whmehaffey/Passive_Commutator_Intan_Interface/Passive Commutator Parts.xlsx

Company | Part | Part #
McMaster Carr | R4A , Plastic Bearing, Glass Ball. | 6455K52 (https://www.mcmaster.com/)
Omnetics | 12-pin Nano Polarized SMT | A79623-001
Moog, Inc. | Brush Block | AC259-10S:
 | Slip Ring | AC2690-10V (Vee Groove) or AC2690-10R (Raise Barrier) | (V- Groove is nice!)
Digikey | Conductive Silver Grease (https://www.digikey.com/product-detail/en/chemtronics/CW7100/CW7100-ND/307001) | CW7100-ND (https://www.digikey.com/product-detail/en/chemtronics/CW7100/CW7100-ND/307001)
