whmehaffey/Passive_Commutator_Intan_Interface/STL/Commutator_Top.stl

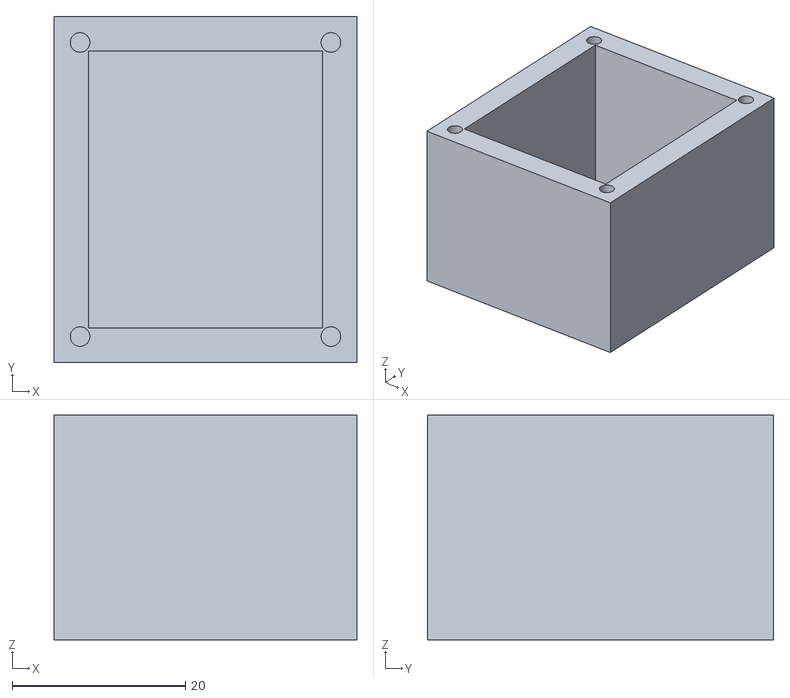
[picture p1: CAD file, 2018-09-08]
STL/Commutator_Top.stl
35.0 x 40.0 x 26.0
