whmehaffey/Passive_Commutator_Intan_Interface/STL/AC2690Sheath.stl

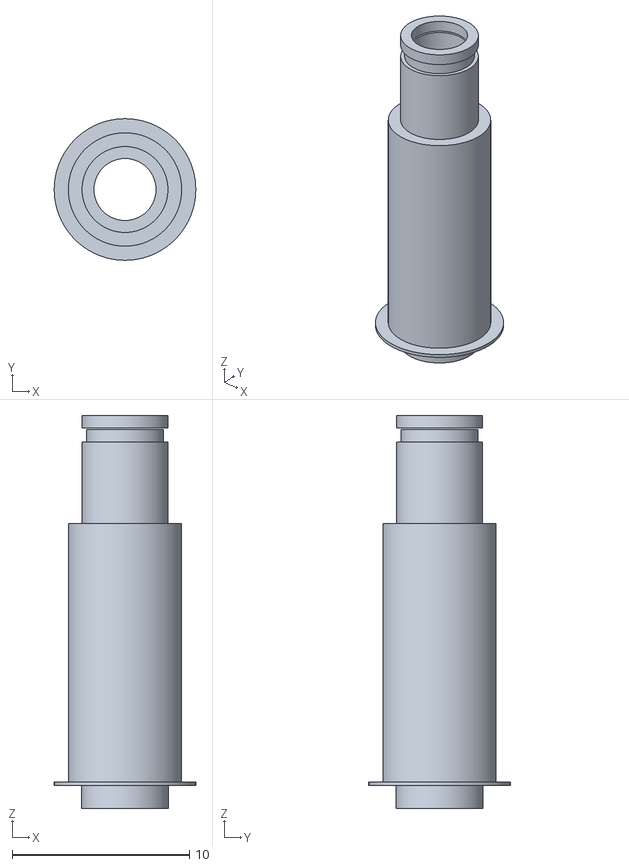
[picture p2: CAD file, 2018-09-08]
STL/AC2690Sheath.stl
8.00 x 8.00 x 22.2
