whmehaffey/Passive_Commutator_Intan_Interface/MOOG_AC2690_toSPI_Commutator_Board.brd

## EAGLE design MOOG_AC2690_toSPI_Commutator_Board.brd (2018-09-08)

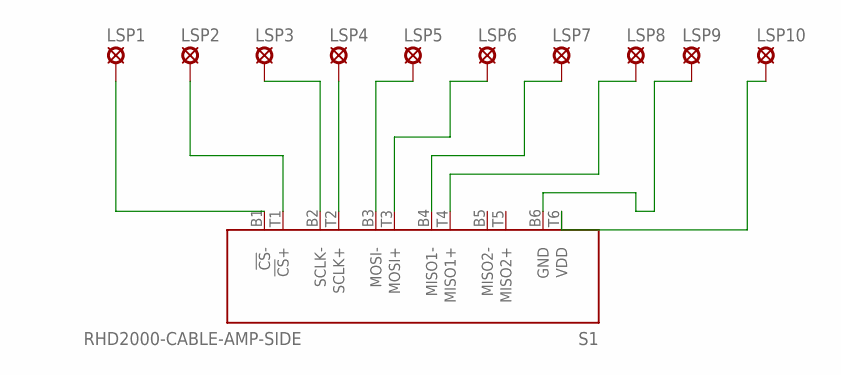
[picture p3: schematic MOOG_AC2690_toSPI_Commutator_Board.sch]

Parts:
LSP1, LSP2, LSP3, LSP4, LSP5, LSP6, LSP7, LSP8, LSP9, LSP10: LSP11
S1: RHD2000-CABLE-AMP-SIDE; OMNETICS_PZN-12-AA

Connections:
unnamed: LSP1.MP, S1.B1 (!CS!-)
unnamed: LSP2.MP, S1.T1 (!CS!+)
unnamed: LSP3.MP, S1.B2 (SCLK-)
unnamed: LSP4.MP, S1.T2 (SCLK+)
unnamed: LSP5.MP, S1.B3 (MOSI-)
unnamed: LSP6.MP, S1.T3 (MOSI+)
unnamed: LSP7.MP, S1.B4 (MISO1-)
unnamed: LSP8.MP, S1.T4 (MISO1+)
unnamed: LSP9.MP, S1.B6 (GND)
unnamed: LSP10.MP, S1.T6 (VDD)

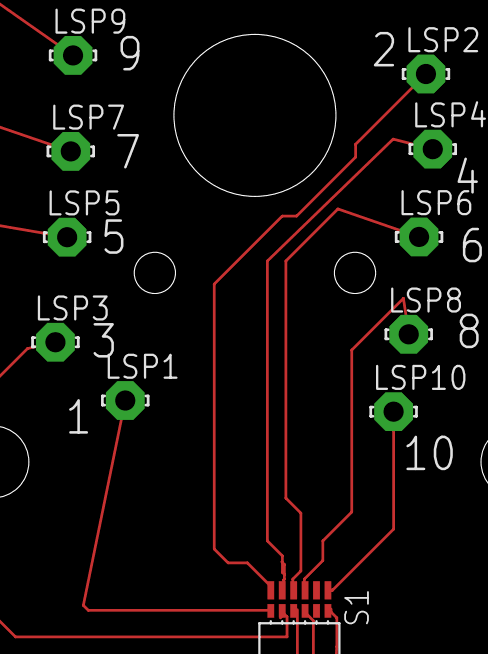
[picture p4: board MOOG_AC2690_toSPI_Commutator_Board.brd from above]

Board: 2 copper layers, 11 parts (0 on the bottom side), 10 nets.
