whmehaffey/Passive_Commutator_Intan_Interface/(commit log)

2018-09-08 First Upload
    First Version, only tested once.
    [AC2690Sheath.stl, Commutator_Top.scad, Commutator_Top.stl, DragonflyPart4.scad, KSBearingholderDoubleC.scad, MOOG_AC2690_toSPI_Commutator_Board - Copy.sch, MOOG_AC2690_toSPI_Commutator_Board.brd, MOOG_AC2690_toSPI_Commutator_Board.sch]
2018-09-08 CleanUp
    Removed extra file (copy of .BRD file)
    [MOOG_AC2690_toSPI_Commutator_Board - Copy.sch]
